Jayabadhrinath/MicroROS-4DOF-Robotic-arm/asrs_arm/meshes/link_4.STL

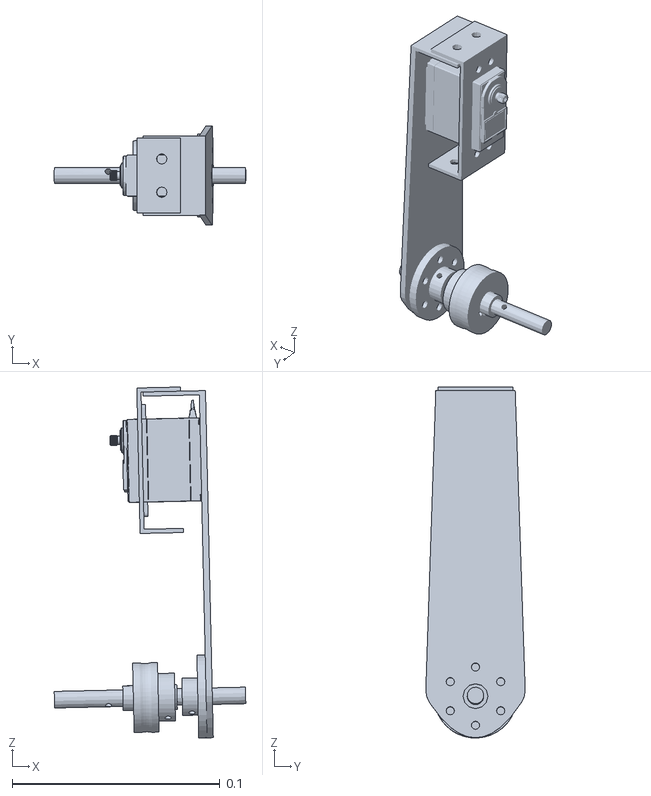
[picture p1: CAD file, 2024-02-02]
asrs_arm/meshes/link_4.STL
0.0922 x 0.0478 x 0.169
