Jayabadhrinath/MicroROS-4DOF-Robotic-arm/asrs_gripper/meshes/left_knuckle.STL

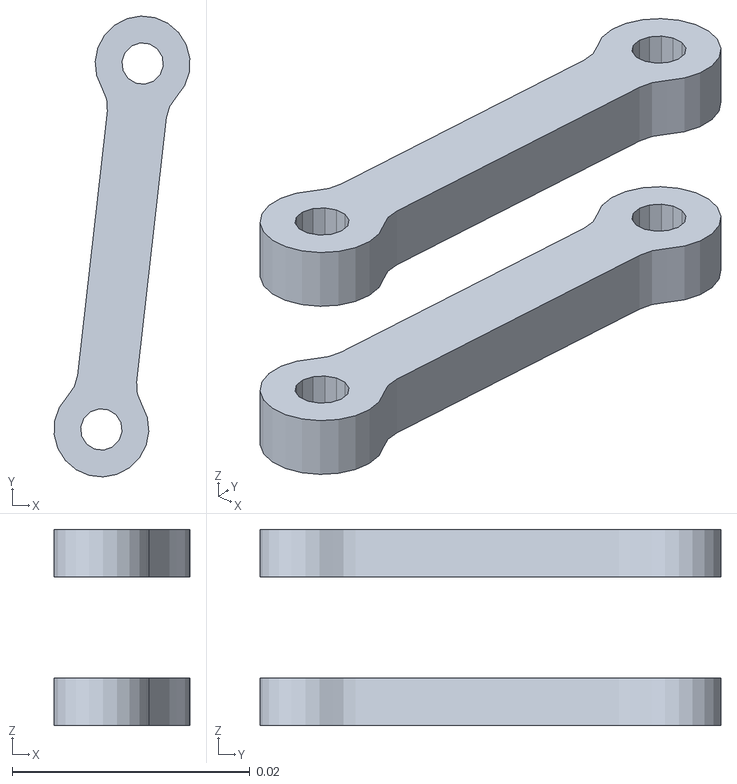
[picture p2: CAD file, 2024-02-02]
asrs_gripper/meshes/left_knuckle.STL
0.0114 x 0.0388 x 0.0165
