Jayabadhrinath/MicroROS-4DOF-Robotic-arm/asrs_arm/meshes/link_3.STL

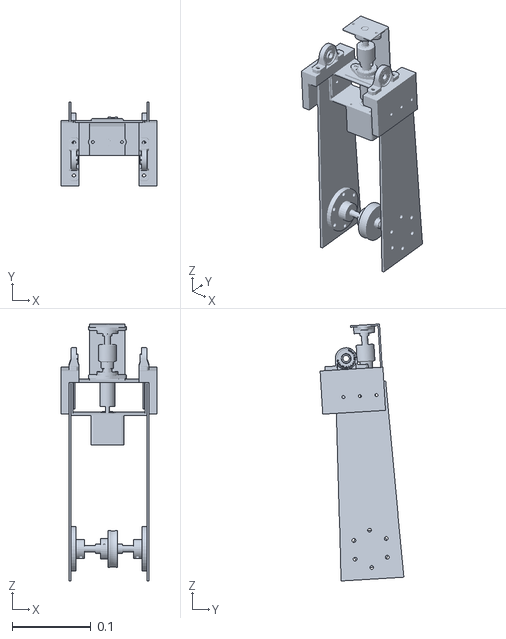
[picture p3: CAD file, 2024-02-02]
asrs_arm/meshes/link_3.STL
0.122 x 0.106 x 0.327
