Jayabadhrinath/MicroROS-4DOF-Robotic-arm/asrs_gripper/meshes/right_finger.STL

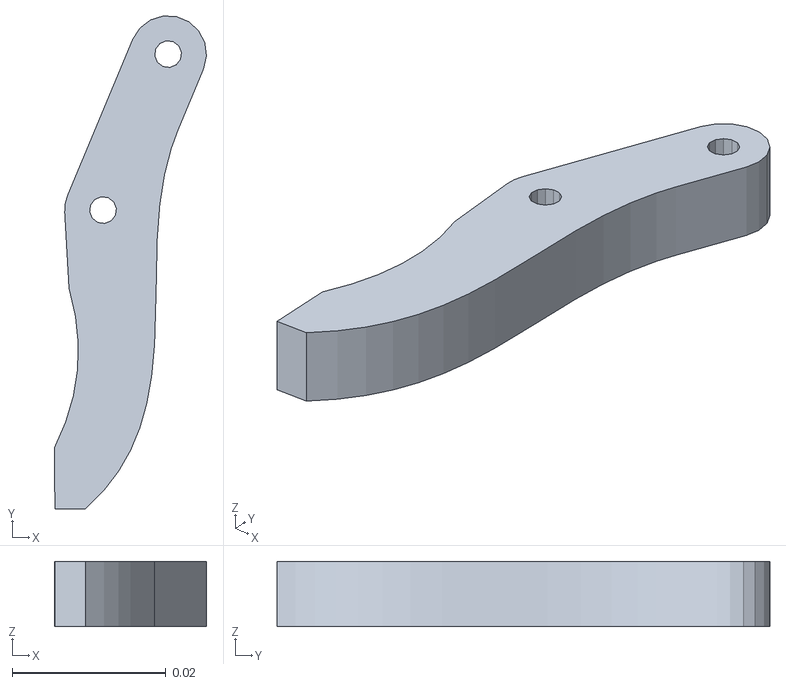
[picture p4: CAD file, 2024-02-02]
asrs_gripper/meshes/right_finger.STL
0.0198 x 0.0642 x 0.0085
