Jayabadhrinath/MicroROS-4DOF-Robotic-arm/asrs_arm/meshes/link_1.STL

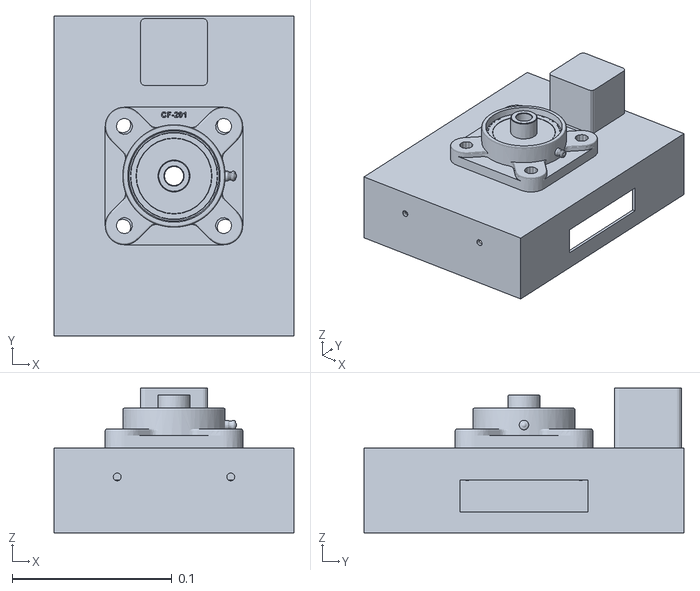
[picture p5: CAD file, 2024-02-02]
asrs_arm/meshes/link_1.STL
0.15 x 0.2 x 0.0905
