Jayabadhrinath/MicroROS-4DOF-Robotic-arm/asrs_gripper/meshes/driver.STL

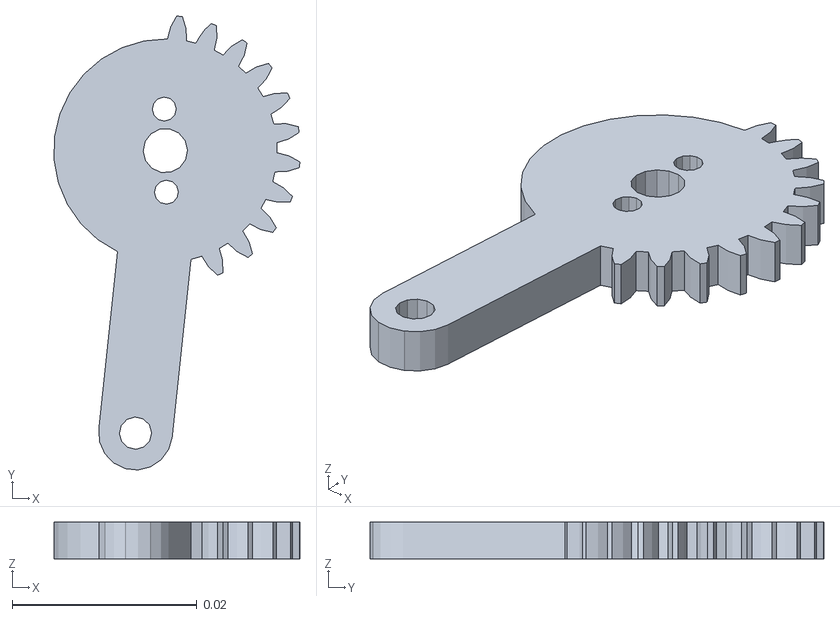
[picture p6: CAD file, 2024-02-02]
asrs_gripper/meshes/driver.STL
0.0266 x 0.0491 x 0.004
