Jayabadhrinath/MicroROS-4DOF-Robotic-arm/asrs_gripper/meshes/driven.STL

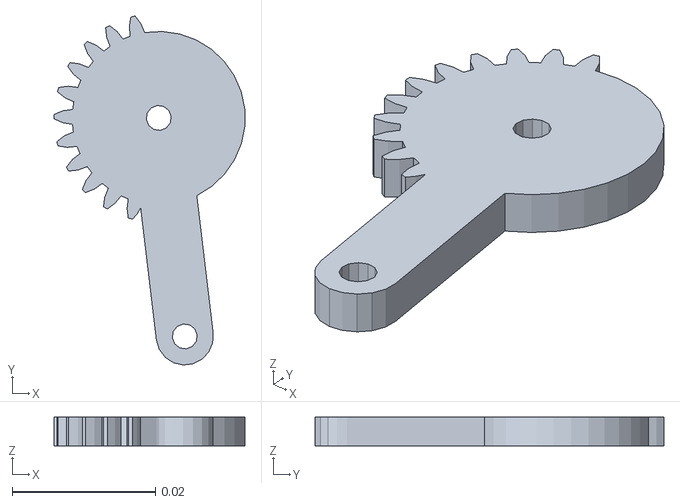
[picture p7: CAD file, 2024-02-02]
asrs_gripper/meshes/driven.STL
0.0267 x 0.0488 x 0.004
