Jayabadhrinath/MicroROS-4DOF-Robotic-arm/asrs_gripper/meshes/base.STL

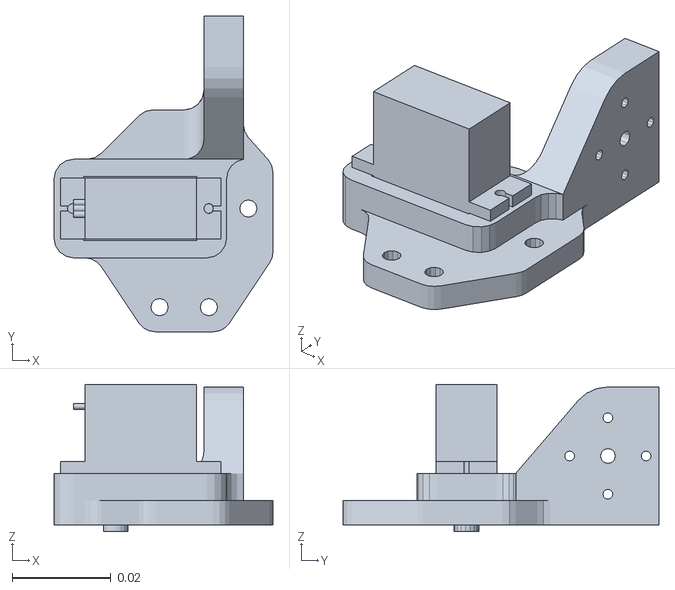
[picture p8: CAD file, 2024-02-02]
asrs_gripper/meshes/base.STL
0.0444 x 0.064 x 0.0299
