Jayabadhrinath/MicroROS-4DOF-Robotic-arm/(list of files, cad)

Other CAD files:
asrs_gripper/meshes/left_finger.STL
asrs_gripper/meshes/right_knuckle.STL
