Jayabadhrinath/MicroROS-4DOF-Robotic-arm/asrs_moveit_config/config/initial_positions.yaml

# Default initial positions for asrs_robot's ros2_control fake system

initial_positions:
  base_to_driver: 0
  joint_1: 0
  joint_2: 0
  joint_3: 0
  joint_4: 0
